vmcruz/esp32-mini-lab/Hardware/KiCad/ESP32-SD-Device.png

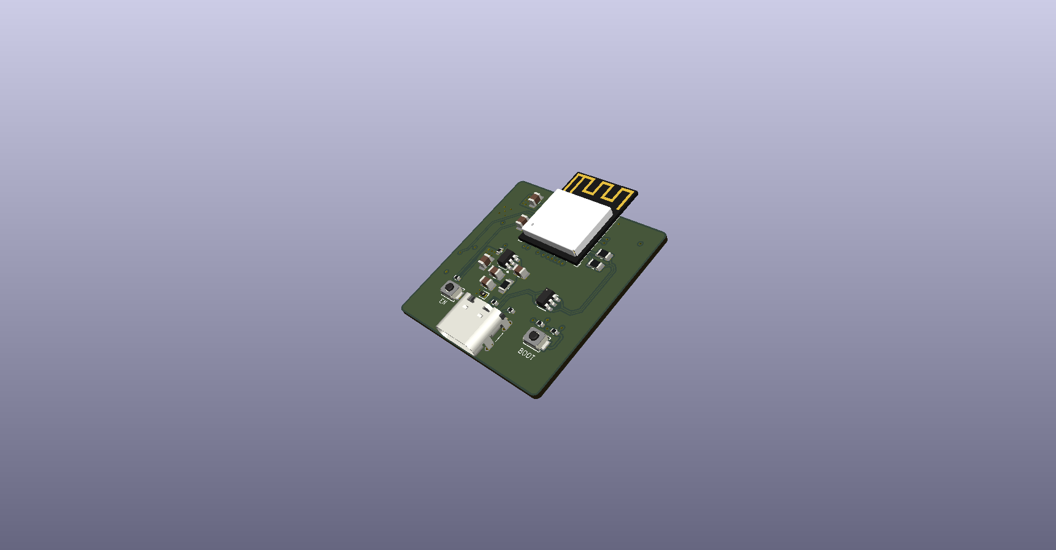
Hardware/KiCad/ESP32-SD-Device.png
