vmcruz/esp32-mini-lab/Hardware/PCBWay/ESP32-BOM.csv

Designator | Qty | Manufacturer | Mfg Part # | Description / Value | Package/Footprint | Type | Your Instructions / Notes
C1,C2,C3,C4 | 4 | Murata Electronics | GRM21BR71A475KE51K | 4.7uF, 10V, X7R, ±10% | 0805 (2012 Metric) | SMD
C5 | 1 | Murata Electronics | GRM21BR61A106KE19K | 10uF, 10V, X5R, ±10% | 0805 (2012 Metric) | SMD
C6 | 1 | Murata Electronics | GRM022R60J104KE15L | 100nF, 6.3V, X5R, ±10% | 01005 (0402 Metric) | SMD
C7 | 1 | Murata Electronics | GRM21BR71A105KA01K | 1uF, 10V, X7R, ±10% | 0805 (2012 Metric) | SMD
D1 | 1 | Nexperia | PESD5V0L1ULD,315 | 5V TVS ESD protection diode | SOD-882D / DFN1006D-2 | SMD
J1 | 1 | GCT | USB4105-GF-A | USB Type-C receptacle, USB 2.0, 16P | USB4105 series, top-mount horizontal | SMD
R1,R2 | 2 | YAGEO | RC0402FR-075K1L | 5.1kOhm, 1%, 1/16W | 0402 (1005 Metric) | SMD
R3,R6 | 2 | YAGEO | RC0805FR-0733RL | 33Ohm, 1%, 1/8W | 0805 (2012 Metric) | SMD
R4,R5,R8,R9 | 4 | YAGEO | RC0402FR-0710KL | 10kOhm, 1%, 1/16W | 0402 (1005 Metric) | SMD
R7 | 1 | YAGEO | RC0805FR-070RL | 0Ohm jumper | 0805 (2012 Metric) | SMD
SW1,SW2 | 2 | OMRON | B3U-1000P | Tactile switch, SPST-NO, top actuated | 3.0 x 2.5mm SMD | SMD
U1 | 1 | STMicroelectronics | USBLC6-2SC6 | USB 2.0 ESD protection, 2 data lines | SOT-23-6 | SMD
U2 | 1 | Diodes Incorporated | AP2112K-3.3TRG1 | 3.3V 600mA LDO | SOT-23-5 | SMD
U3 | 1 | Espressif Systems | ESP32-C3-MINI-1-N4X | ESP32-C3 module, integrated 4MB flash, PCB antenna | ESP32-C3-MINI-1 | SMD
