vmcruz/esp32-mini-lab/Hardware/Enclosure/Enclosure.stl

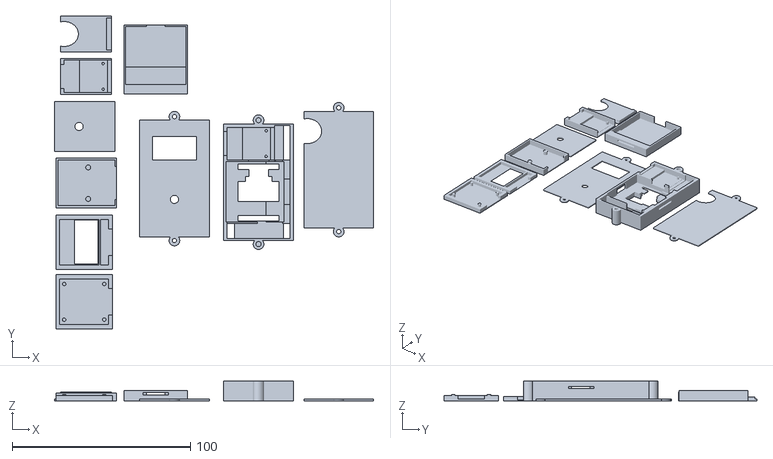
[picture p3: CAD file, 2026-10-19]
Hardware/Enclosure/Enclosure.stl
179.2 x 175.7 x 11.0
