vmcruz/esp32-mini-lab/Hardware/KiCad/ESP32-SD-Device.stl

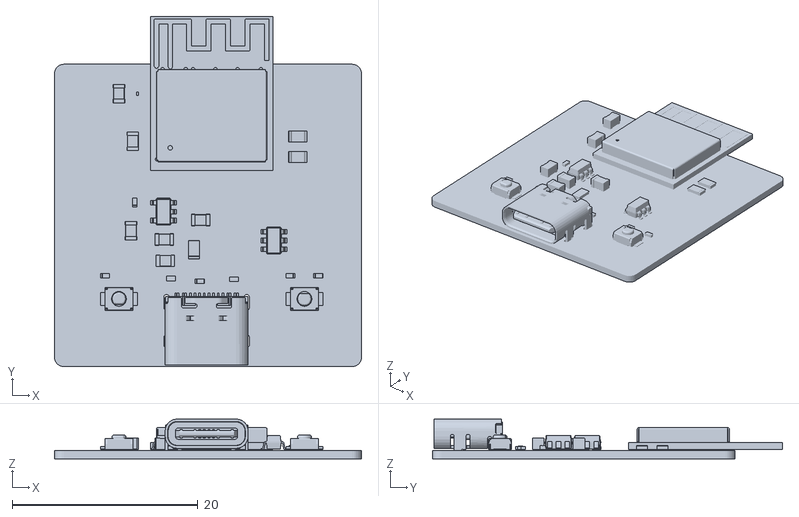
[picture p4: CAD file, 2026-10-19]
Hardware/KiCad/ESP32-SD-Device.stl
33.1 x 37.8 x 4.30
