vmcruz/esp32-mini-lab/Hardware/KiCad/ESP32-SD-Device.kicad_pcb

## KiCad design Hardware/KiCad/ESP32-SD-Device.kicad_pcb (2026-10-19)

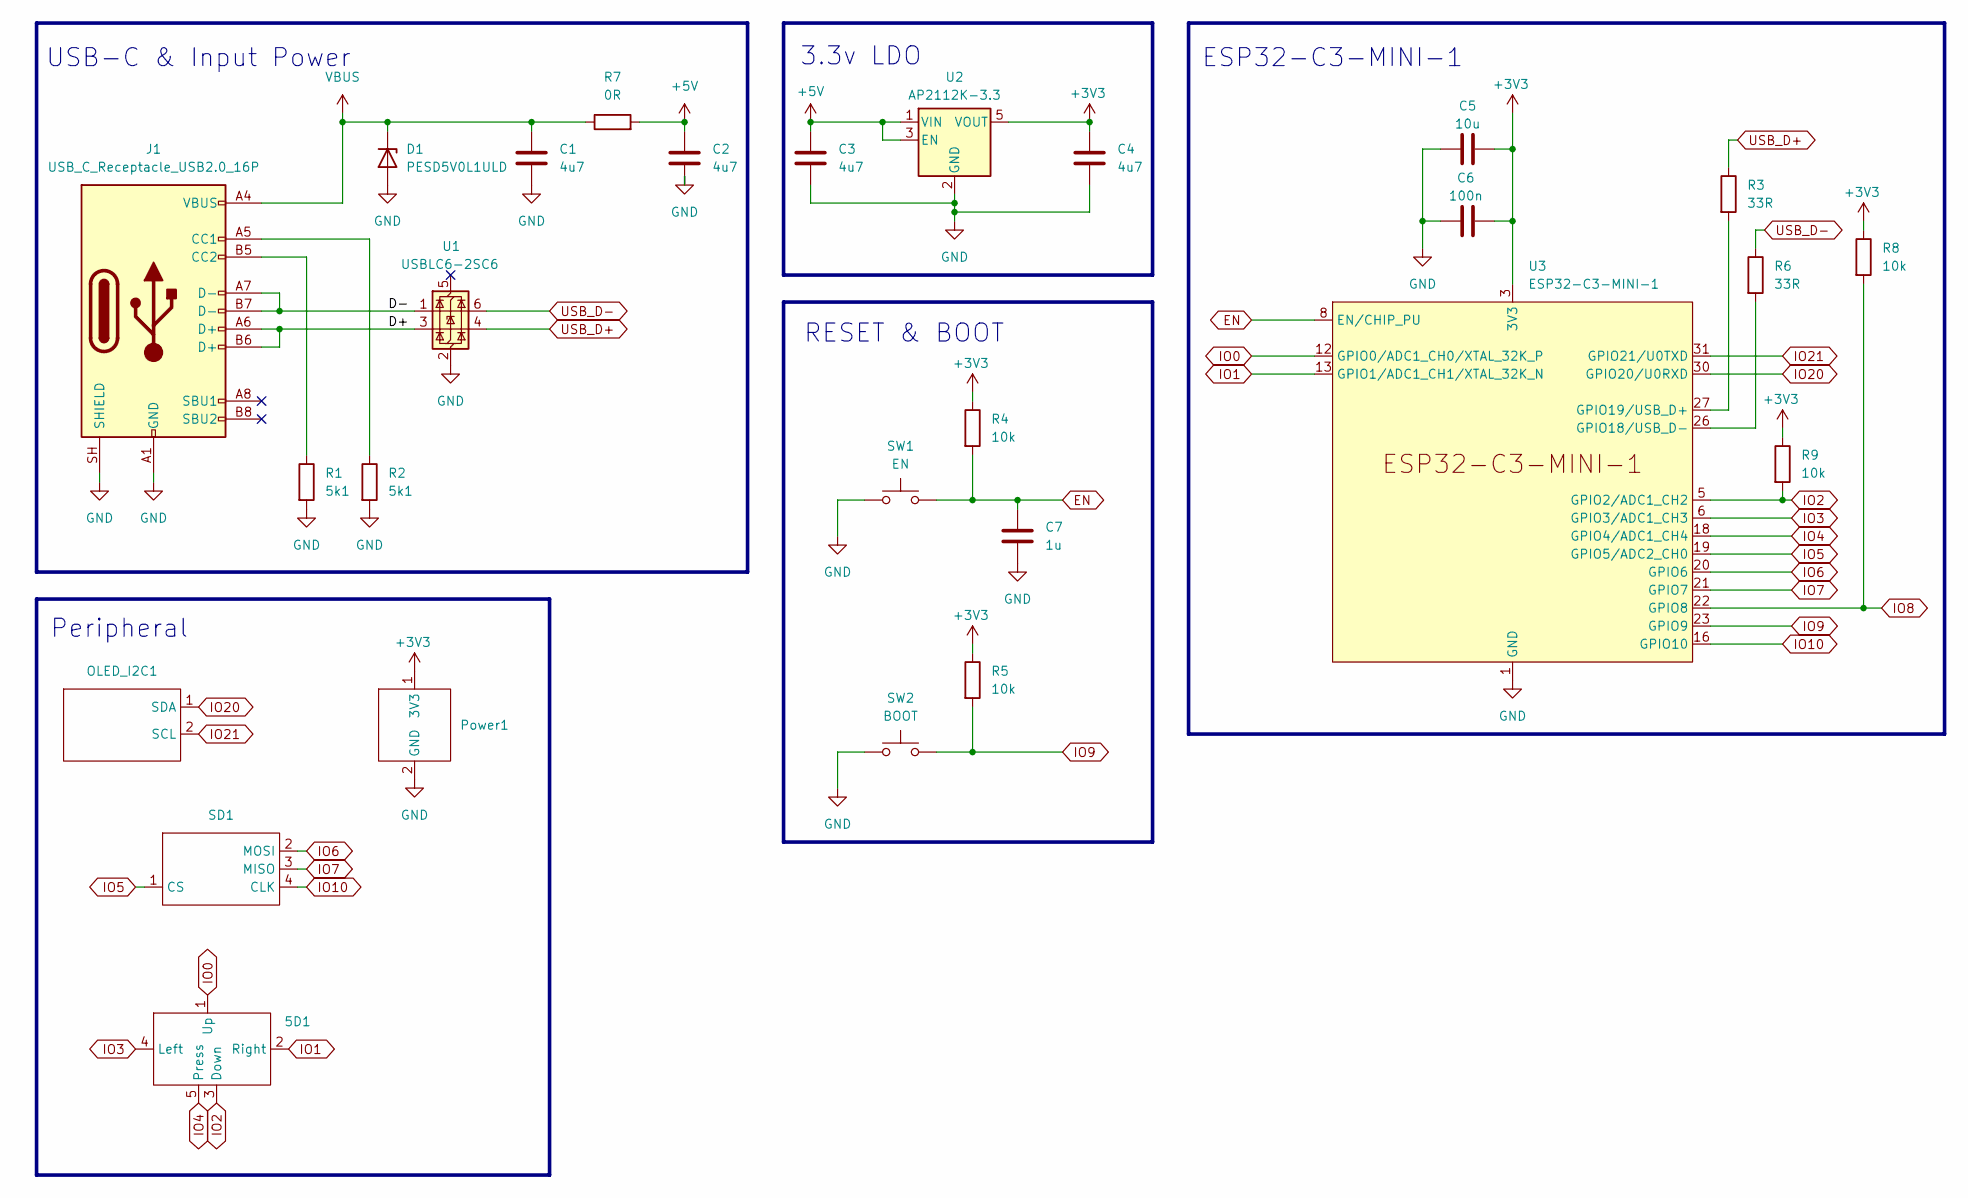
[picture p5: schematic ESP32C3MINI1.kicad_sch, ESP32-Mini-Lab]

Parts:
5D1: 5D_Interface
C1, C2, C3, C4: 4u7; C_0805_2012Metric
C5: 10u; C_0805_2012Metric
C6: 100n; C_01005_0402Metric
C7: 1u; C_0805_2012Metric
D1: PESD5V0L1ULD; D_SOD-882D
J1: USB_C_Receptacle_USB2.0_16P; USB_C_Receptacle_GCT_USB4105-xx-A_16P_TopMnt_Horizontal
OLED_I2C1: OLED_Interface
Power1: Power_Interface
R1, R2: 5k1; R_0402_1005Metric
R3, R6: 33R; R_0805_2012Metric
R4, R5, R8, R9: 10k; R_0402_1005Metric
R7: 0R; R_0805_2012Metric
SD1: SD_Interface
SW1: EN; SW_SPST_B3U-1000P
SW2: BOOT; SW_SPST_B3U-1000P
U1: USBLC6-2SC6; SOT-23-6
U2: AP2112K-3.3; SOT-23-5
U3: ESP32-C3-MINI-1

Connections:
+3V3: C4.1, C5.2, C6.2, Power1.1 (3V3), R4.1, R5.1, R8.1, R9.1, U2.5 (VOUT), U3.3 (3V3)
+5V: C2.1, C3.1, R7.2, U2.1 (VIN), U2.3 (EN)
/ESP32-C3-MINI-1/D+: J1.A6 (D+), J1.B6 (D+), U1.3 (I/O2)
/ESP32-C3-MINI-1/D-: J1.A7 (D-), J1.B7 (D-), U1.1 (I/O1)
EN: C7.1, R4.2, SW1.2, U3.8 (EN/CHIP_PU)
GND: C1.2, C2.2, C3.2, C4.2, C5.1, C6.1, C7.2, D1.2 (A), J1.A1 (GND), J1.A12 (GND), J1.B1 (GND), J1.B12 (GND), J1.SH (SHIELD), Power1.2 (GND), R1.2, R2.2, SW1.1, SW2.1, U1.2 (GND), U2.2 (GND), U3.1 (GND), U3.2 (GND), U3.11 (GND), U3.14 (GND), U3.36 (GND), U3.37 (GND), U3.38 (GND), U3.39 (GND), U3.40 (GND), U3.41 (GND), U3.42 (GND), U3.43 (GND), U3.44 (GND), U3.45 (GND), U3.46 (GND), U3.47 (GND), U3.48 (GND), U3.49 (GND), U3.50 (GND), U3.51 (GND), U3.52 (GND), U3.53 (GND)
IO0: 5D1.1 (Up), U3.12 (GPIO0/ADC1_CH0/XTAL_32K_P)
IO1: 5D1.2 (Right), U3.13 (GPIO1/ADC1_CH1/XTAL_32K_N)
IO2: 5D1.3 (Down), R9.2, U3.5 (GPIO2/ADC1_CH2)
IO3: 5D1.4 (Left), U3.6 (GPIO3/ADC1_CH3)
IO4: 5D1.5 (Press), U3.18 (GPIO4/ADC1_CH4)
IO5: SD1.1 (CS), U3.19 (GPIO5/ADC2_CH0)
IO6: SD1.2 (MOSI), U3.20 (GPIO6)
IO7: SD1.3 (MISO), U3.21 (GPIO7)
IO8: R8.2, U3.22 (GPIO8)
IO9: R5.2, SW2.2, U3.23 (GPIO9)
IO10: SD1.4 (CLK), U3.16 (GPIO10)
IO20: OLED_I2C1.1 (SDA), U3.30 (GPIO20/U0RXD)
IO21: OLED_I2C1.2 (SCL), U3.31 (GPIO21/U0TXD)
unnamed: J1.A5 (CC1), R2.1
unnamed: J1.B5 (CC2), R1.1
unnamed: R6.2, U3.26 (GPIO18/USB_D-)
unnamed: R3.2, U3.27 (GPIO19/USB_D+)
USB_D+: R3.1, U1.4 (I/O2)
USB_D-: R6.1, U1.6 (I/O1)
VBUS: C1.1, D1.1 (K), J1.A4 (VBUS), J1.A9 (VBUS), J1.B4 (VBUS), J1.B9 (VBUS), R7.1

Notes on the sheet:
3.3v LDO
Peripheral
USB-C & Input Power
ESP32-C3-MINI-1
RESET & BOOT

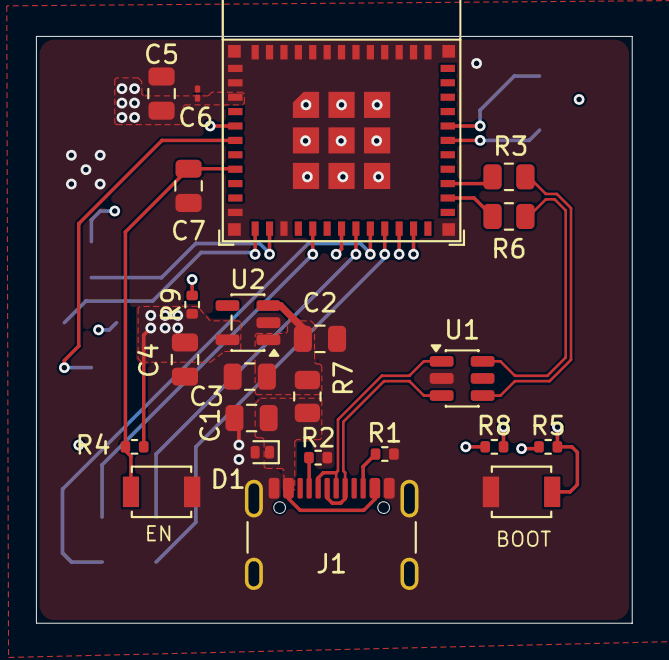
[picture p6: board ESP32-SD-Device.kicad_pcb from above]

Board: 4 copper layers, 33.1 x 32.6 mm, 27 parts (0 on the bottom side), 26 nets.
