vmcruz/esp32-mini-lab/TODO.md

## V2 — Improvements and TODO

### Mechanical Design

- [ ] **Improve faceplate cable clearance**
  - Add sufficient clearance for the internal wiring.
  - Consider adding cable routing channels.
  - Prevent cables from pushing against the enclosure.
  - Review the 1.5 mm cable clearance used in the backplate as a reference.

- [ ] **Improve enclosure closure**
  - Add a perimeter lip to align the faceplate and backplate.
  - Add four retention clips (two per side).
  - Validate clip flexibility and durability when printed in PLA.
  - Ensure the clips can be released without damaging the enclosure.
  - Avoid additional screws that interfere with internal components.

- [ ] **Add recessed screw heads**
  - Add countersinks or cylindrical recesses for the M2 screw heads.
  - Initial reference: 3.8 mm recess diameter for 3.5 mm screw heads.
  - Adjust recess depth according to the actual screw head thickness.
  - Ensure the device rests flat on a surface without rocking.

### Ergonomics and Finishing

- [ ] **Round external corners and edges**
  - Add fillets to improve grip comfort.
  - Remove sharp edges that cause discomfort when holding the device.
  - Test different corner radii before printing the next version.

### Fit and Assembly

- [ ] **Validate component clearances**
  - Check PCB, display, and D-pad alignment.
  - Verify USB-C port and microSD card accessibility.
  - Ensure screws and brass heat-set inserts do not interfere with internal components.
  - Verify that all components fit without excessive pressure.

### Print Optimization

- [ ] **Review support requirements**
  - Evaluate whether internal floating surfaces can be redesigned.
  - Consider ribs or self-supporting geometries to reduce support material.
  - Keep supports where they remain the simplest and most reliable option.

### Validation

- [ ] **Test snap-fit clips separately before printing the complete enclosure.**
- [ ] **Print and assemble the complete V2 enclosure.**
- [ ] **Perform field testing and document any additional issues.**
